Lzw655/KiCad_Library/README.md

# KiCad Libraries & Projects

## Plugins

### Manufacturing BOM and Gerbers

* [kicad-jlcpcb-tools](https://github.com/Bouni/kicad-jlcpcb-tools): JLCPCB Tools

### View

* Interactive Html Bom (internal): Generate Interactive HTML BOM
* Board2Pdf (internal): Board2Pdf

### Tools

* KiBuzzard (internal): Create Labels
* [pcb-action-tools (modified)](./3rdparty/custom/plugins/pcb-action-tools_v1.0.6~_pcm.zip):
    * Annular checker
    * Snap Selected Footprint(s) to Grid
    * Move Selected Drawings to chosen Layer
* KiKit & KiKit Library (internal) ([Installation Guide](https://yaqwsx.github.io/KiKit/v1.4/installation/intro/)):
    * KiKit: Show/hide references
    * KiKit: Panelize PCB

## Libraries

### SoC

* [Espressif kicad-libraries](https://github.com/espressif/kicad-libraries)
