Lzw655/KiCad_Library/projects/power_ex_board/power_ex_board.kicad_pcb

## KiCad design projects/power_ex_board/power_ex_board.kicad_pcb (2023-09-21)

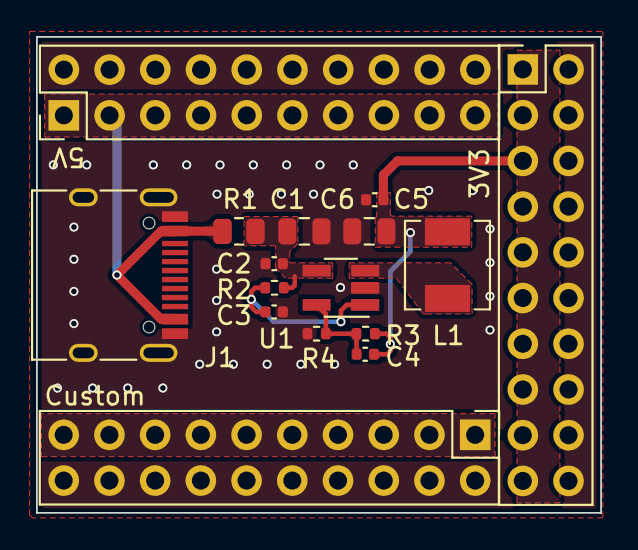
[picture p1: board power_ex_board.kicad_pcb from above]

Board: 2 copper layers, 31.3 x 26.4 mm, 16 parts (0 on the bottom side), 8 nets.

Parts:
3V3: 3V3; PinHeader_2x10_P2.54mm_Vertical
5V: 5V; PinHeader_2x10_P2.54mm_Vertical
C1, C6: 10uF/16V(10%); C_0805_2012Metric
C2: 100nF/16V(10%); C_0402_1005Metric
C3: 1uF/16V(10%)(NC); C_0402_1005Metric
C4: 22pF/50V(5%); C_0402_1005Metric
C5: 100nF/10V(5%); C_0402_1005Metric
Custom: Custom; PinHeader_2x10_P2.54mm_Vertical
J1: USB_C_Receptacle_USB2.0; USB_C_Receptacle_HRO_TYPE-C-31-M-12
L1: 2.2uH(20%); L_Sunlord_MWSA0402S
R1: 0(1%); R_0805_2012Metric
R2: 10K(1%); R_0402_1005Metric
R3: 680K(1%); R_0402_1005Metric
R4: 150K(1%); R_0402_1005Metric
U1: ETA3409S2F; SOT-23-5_HandSoldering

Connections:
+3V3: 3V3.1, 3V3.3, 3V3.5, 3V3.7, 3V3.9, 3V3.11, 3V3.13, 3V3.15, 3V3.17, 3V3.19, C4.1, C5.1, C6.1, L1.2, R3.1
+5V: 5V.1, 5V.3, 5V.5, 5V.7, 5V.9, 5V.11, 5V.13, 5V.15, 5V.17, 5V.19, J1.A4 (VBUS), J1.A9 (VBUS), J1.B4 (VBUS), J1.B9 (VBUS), R1.1
GND: 3V3.2, 3V3.4, 3V3.6, 3V3.8, 3V3.10, 3V3.12, 3V3.14, 3V3.16, 3V3.18, 3V3.20, 5V.2, 5V.4, 5V.6, 5V.8, 5V.10, 5V.12, 5V.14, 5V.16, 5V.18, 5V.20, C1.2, C2.2, C3.2, C5.2, C6.2, Custom.2, Custom.4, Custom.6, Custom.8, Custom.10, Custom.12, Custom.14, Custom.16, Custom.18, Custom.20, J1.A1 (GND), J1.A12 (GND), J1.B1 (GND), J1.B12 (GND), J1.S1 (SHIELD), R4.2, U1.2 (GND)
unnamed: C3.1, R2.1, U1.1 (EN)
unnamed: C4.2, R3.2, R4.1, U1.5 (FB)
unnamed: C1.1, C2.1, R1.2, R2.2, U1.4 (IN)
unnamed: L1.1, U1.3 (LX)
VCC: Custom.1, Custom.3, Custom.5, Custom.7, Custom.9, Custom.11, Custom.13, Custom.15, Custom.17, Custom.19
